ilanmer2205/RiscV-Proccessor-with-FIFO-and-UART-TX/README

For a more detailed explanation on the RISC-V processor, check out the the following repository (https://github.com/ilanmer2205/RiscV_Piplined_RV32I_Processor)
