ilanmer2205/RiscV-Proccessor-with-FIFO-and-UART-TX/RiscV_Piplined_RV32/RTL_Design/Main/riscv_main.v

module riscv_main
    (
    input clk, reset,
    input fifo_am_full,
    input [31:0] ReadDataM, 
    input [31:0] InstrF, 
    output [31:0] PCF,
    output MemWriteM,
    output [31:0] ALUResultM, WriteDataM,
    output [2:0] Func3M,
    output En_fifo,
    output [31:0] ResultW);
    
    wire RegWriteM, RegWriteW;
    wire [1:0] ResultSrcE, ResultSrcW;
    wire [3:0] ALUControlE;
    wire ALUSrcE;
    wire [2:0] ImmSrcD;
    
    wire StallF, StallD; 
    wire FlushD, FlushE;
    wire [1:0] ForwardAE, ForwardBE;

    wire [4:0] Rs1D, Rs2D;
    wire [4:0] Rs1E, Rs2E;
    wire [4:0] RdE, RdM, RdW;
    wire [31:0] InstrD;

    wire Zero;
    wire PCSrcE;
    wire [6:0] op;
    wire [2:0] func3, Func3E;
    wire func7;
    wire AOperandE;
    wire ForwardValMuxM;
    
    assign op = InstrD[6:0];
    assign func3 = InstrD[14:12];
    assign func7 = InstrD[30];
    
    control_unit c(clk, reset, fifo_am_full, op, func3, Func3E, func7, Zero, FlushE, PCSrcE, RegWriteM,
                    RegWriteW, ResultSrcE, ResultSrcW, MemWriteM, ALUControlE,
                     ALUSrcE, ImmSrcD, AOperandE, ForwardValMuxM, En_fifo);

    data_path dp(clk, reset, StallF, StallD, FlushD, FlushE, ForwardAE, ForwardBE,
                  RegWriteW, ImmSrcD, PCSrcE, ALUSrcE, ALUControlE, ResultSrcW, ReadDataM,
                   InstrF, AOperandE, ForwardValMuxM, Zero, PCF, ALUResultM, WriteDataM, Rs1D, Rs2D, Rs1E, Rs2E, RdE, RdM,
                    RdW, InstrD, Func3M, Func3E, ResultW);
        
    hazard_control hzrd ( fifo_am_full, Rs1D, Rs1E, Rs2D, Rs2E, RdE, RdM, RdW, PCSrcE, RegWriteM, RegWriteW, ResultSrcE,
                          StallF, StallD, FlushD, FlushE, ForwardAE, ForwardBE);
    
endmodule





 
 
