ilanmer2205/RiscV-Proccessor-with-FIFO-and-UART-TX/RiscV_Piplined_RV32/RTL_Design/Control_Unit/control_unit - Copy.v

module control_unit(
    input clk, reset,
    input fifo_am_full,
    input [6:0] op,
    input [2:0] funct3, func3E,
    input funct7,
    input Zero,
    input FlushE,
    
    output PCSrcE,
    output RegWriteM, RegWriteW,
    output [1:0] ResultSrcE, ResultSrcW,
    output MemWriteM,
    output [3:0] ALUControlE, 
    output ALUSrcE,
    output [2:0] ImmSrcD,
    output AOperandE,
    output ForwardValMuxM,
    output En_fifoW
    );
    
    wire [1:0] funct7b5;

    wire RegWriteD, RegWriteE;
    wire [1:0] ResultSrcD, ResultSrcM;
    wire MemWriteD, MemWriteE;
    wire JumpD, JumpE;
    wire BranchD, BranchE;
    wire [3:0] ALUControlD;
    wire ALUSrcD;
    wire [1:0] ALUOp;
    wire AOperandD;
    wire ForwardValMuxD, ForwardValMuxE;
    wire Instruction_on;
    
    assign funct7b5 = {funct7, op[5]};
    assign En_fifoD = !fifo_am_full && Instruction_on;
    
    main_decoder maindec(op, ResultSrcD, MemWriteD, BranchD, ALUSrcD, RegWriteD, JumpD, ImmSrcD, ALUOp, AOperandD, ForwardValMuxD, Instruction_on);
    
    alu_decoder aludec(funct3, funct7b5, ALUOp, ALUControlD);

    Branch_Control Branch_con (BranchE, JumpE, Zero, func3E, PCSrcE);

    //Execute cycle reg
    flopr_clr_cexe cexereg(clk, reset, FlushE, RegWriteD, RegWriteE, ResultSrcD, ResultSrcE ,MemWriteD, MemWriteE, JumpD, JumpE,BranchD, BranchE, 
            ALUControlD, ALUControlE, ALUSrcD, ALUSrcE, AOperandD, AOperandE, ForwardValMuxD, ForwardValMuxE, En_fifoD, En_fifoE);
    //Memory cycle reg
    flopr_cmem cmemreg (clk, reset, RegWriteE, RegWriteM, ResultSrcE, ResultSrcM, MemWriteE, MemWriteM, ForwardValMuxE,
            ForwardValMuxM, En_fifoE, En_fifoM);
    //Write Back cycle reg
    flopr_cwb cwbreg (clk, reset, RegWriteM, RegWriteW, ResultSrcM, ResultSrcW, En_fifoM, En_fifoW);

endmodule







//module control_unit(
//    input [6:0] op,
//    input [2:0] funct3,
//    input funct7,
//    input Zero,
//    output PCSrc,
//    output reg [1:0] ResultSrc,
//    output reg MemWrite,
//    output reg [2:0] ALUControl, 
//    output reg ALUSrc,
//    output reg [1:0] ImmSrc,
//    output reg RegWrite,
//    output reg Jump
//    );
    
//    reg [1:0] ALUOp;
//    reg Branch;
    
//    assign PCSrc= (Branch & Zero) | (Jump);
    
////    assign ALUControl= (ALUOp==2'b00) ? 3'b000 :
////                       (ALUOp==2'b01) ? 3'b001 :
////                       (ALUOp==2'b10) ?   
//    //Main Decoder:
//    always@ * begin
//        case(op)
//            7'b0000011: begin //lw= 10010010000
//                RegWrite<= 1'b1;
//                ImmSrc<= 2'b00;
//                ALUSrc<= 1'b1;
//                MemWrite<= 1'b0;
//                ResultSrc<= 2'b01;
//                Branch<= 1'b0;
//                ALUOp<= 2'b00;
//                Jump<= 1'b0;
//            end
//            7'b0100011: begin //sw= 00111000000
//                RegWrite<= 1'b0;
//                ImmSrc<= 2'b01;
//                ALUSrc<= 1'b1;
//                MemWrite<= 1'b1;
//                ResultSrc<= 2'b00; //don't care
//                Branch<= 1'b0;
//                ALUOp<= 2'b00;
//                Jump<= 1'b0;
//            end
//            7'b0110011: begin //R-Type
//                RegWrite<= 1'b1;
//                ImmSrc<= 2'b00; //don't care
//                ALUSrc<= 1'b0; 
//                MemWrite<= 1'b0;
//                ResultSrc<= 2'b00;
//                Branch<= 1'b0;
//                ALUOp<= 2'b10;
//                Jump<= 1'b0;
//            end
//            7'b1100011: begin //beq
//                RegWrite<= 1'b0;
//                ImmSrc<= 2'b10;
//                ALUSrc<= 1'b0;
//                MemWrite<= 1'b0;
//                ResultSrc<= 2'b00; //don't care
//                Branch<= 1'b1;
//                ALUOp<= 2'b01;
//                Jump<= 1'b0;
//            end
//            7'b0010011: begin //addi, I Type ALU
//                RegWrite<= 1'b1;
//                ImmSrc<= 2'b00;
//                ALUSrc<= 1'b1;
//                MemWrite<= 1'b0;
//                ResultSrc<= 2'b00; //don't care
//                Branch<= 1'b0;
//                ALUOp<= 2'b10;
//                Jump<= 1'b0;
//            end
//            7'b1101111: begin //jal
//                RegWrite<= 1'b1;
//                ImmSrc<= 2'b11;
//                ALUSrc<= 1'b0; //don't care
//                MemWrite<= 1'b0;
//                ResultSrc<= 2'b10; //don't care
//                Branch<= 1'b0;
//                ALUOp<= 2'b00; //don't care 
//                Jump<= 1'b1;
//            end
//            default: begin
//                RegWrite<= 1'b0;
//                ImmSrc<= 2'b00;
//                ALUSrc<= 1'b0;
//                MemWrite<= 1'b0;
//                ResultSrc<= 1'b0;
//                Branch<= 1'b0;
//                ALUOp<= 2'b00;
//                Jump<= 1'b0;
//            end    
//        endcase
//    end
    
    
//    //ALU Decoder:
//    always@ * begin
//        case(ALUOp)
//            2'b00:
//                ALUControl= 3'b000; // add (lw,sw)
//            2'b01:
//                ALUControl= 3'b001; // sub (beq) 
//            default: 
//                case(funct3)
//                    3'b000:
//                        if({funct7, op[5]}== 2'b11)
//                            ALUControl= 3'b001; //sub
//                        else // {funct7, op[5]} == 2'b00 | 2'b01 | 2'b10 )
//                            ALUControl= 3'b000; // add
//                    3'b010:
//                        ALUControl= 3'b101; //slt
//                    3'b110:
//                        ALUControl= 3'b011; //or
//                    3'b111:
//                        ALUControl= 3'b010; //and
//                    default: 
//                        ALUControl= 3'b000;
//                endcase
////            default:
////                ALUControl= 3'b000;
//        endcase   
//    end
    
//endmodule
