ilanmer2205/RiscV-Proccessor-with-FIFO-and-UART-TX/RiscV_Piplined_RV32/RTL_Design/Data_Path/alu - Copy.v

`timescale 1ns / 1ps
//////////////////////////////////////////////////////////////////////////////////
// Company: 
// Engineer: 
// 
// Create Date: 17.10.2025 14:05:54
// Design Name: 
// Module Name: alu
// Project Name: 
// Target Devices: 
// Tool Versions: 
// Description: 
// 
// Dependencies: 
// 
// Revision:
// Revision 0.01 - File Created
// Additional Comments:
// 
//////////////////////////////////////////////////////////////////////////////////


module alu(
    input [31:0] SrcA,
    input [31:0] SrcB,
    input [3:0] ALUControl,
    output Zero,
    output reg [31:0] ALUResult
    );
    
    //Set of operation based on page 247
//    assign ALUResult= (ALUControl==3'b000) ? (SrcA + SrcB) : 
//                      (ALUControl==3'b001) ? (SrcA - SrcB) :
//                      (ALUControl==3'b010) ? (SrcA & SrcB) :
//                                            (SrcA | SrcB); //  (ALUControl==2'b11)
    always @(*) begin
        ALUResult = 32'b0;
        case (ALUControl)
            4'b0000: ALUResult = SrcA + SrcB; // ADD
            4'b0001: ALUResult = SrcA - SrcB; // SUB
            4'b0010: ALUResult = SrcA & SrcB; // AND
            4'b0011: ALUResult = SrcA | SrcB; // OR
            4'b0100: ALUResult = SrcA ^ SrcB; // XOR
            4'b0101: ALUResult = SrcA << SrcB[4:0]; // SLL
            4'b0110: ALUResult = SrcA >> SrcB[4:0]; // SRL
            4'b0111: ALUResult = $signed(SrcA) >>> SrcB[4:0]; // SRA 
            4'b1000: ALUResult = ($signed(SrcA) < $signed(SrcB)) ? 32'b1 : 32'b0; // SLT
            4'b1001: ALUResult = ($unsigned(SrcA) < $unsigned(SrcB)) ? 32'b1 : 32'b0; // SLTU
            default: ALUResult = 32'b0;
        endcase
end
    
 
                    
    assign Zero= (ALUResult==0) ? 1 : 0; 
                   
endmodule

//    always@ (*) begin
//        case (ALUControl) 
//            3'b000: ALUResult= (SrcA + SrcB);
//            3'b001: ALUResult= (SrcA - SrcB);
//            3'b010: ALUResult= (SrcA & SrcB);
//            3'b011: ALUResult= (SrcA | SrcB);
//            3'b101: ALUResult= ($signed(SrcA) < $signed(SrcB)) ? 32'b1 : 32'b0; 
//            3'b110: ALUResult= ($unsigned(SrcA) < $unsigned(SrcB)) ? 32'b1 : 32'b0;        
//            default: ALUResult=0;
//        endcase
//    end 
