ilanmer2205/RiscV-Proccessor-with-FIFO-and-UART-TX/RiscV_Piplined_RV32/RTL_Design/Data_Path/flopenr - Copy.v

`timescale 1ns / 1ps
//////////////////////////////////////////////////////////////////////////////////
// Company: 
// Engineer: 
// 
// Create Date: 17.10.2025 14:05:54
// Design Name: 
// Module Name: flopenr
// Project Name: 
// Target Devices: 
// Tool Versions: 
// Description: 
// 
// Dependencies: 
// 
// Revision:
// Revision 0.01 - File Created
// Additional Comments:
// 
//////////////////////////////////////////////////////////////////////////////////


module flopenr #(parameter WIDTH = 8)
(input clk, reset, en, 
 input [WIDTH-1:0] d,
 output reg [WIDTH-1:0] q);
 
 always@ (posedge clk, posedge reset)
     if (reset) q<= 0;
     else if (~en) q <= d;
 
endmodule
