ilanmer2205/RiscV-Proccessor-with-FIFO-and-UART-TX/RiscV_Piplined_RV32/RTL_Design/Hazard_Controller/stall_flush.v

 module stall_flush 
 	(
 	input fifo_am_full,
	input [4:0] Rs1D, Rs2D, 
	input [4:0] RdE, 
	input PCSrcE, 
	input [1:0] ResultSrcE,

	output StallF, StallD,
	output FlushD, FlushE
	);

 	wire lwStall;

 	assign lwStall = (ResultSrcE == 2'b01 ) & ((Rs1D == RdE) | (Rs2D == RdE));
 	
    assign StallF = (lwStall || fifo_am_full);
    assign StallD = (lwStall || fifo_am_full);

    assign FlushD = PCSrcE;
    assign FlushE = lwStall | PCSrcE;

 endmodule 
